pann/DifferentialActiveProbe/docs/test-runner.html

# Differential Probe - Test Runner

Save Data Load Data ✓ Saved Link Definitions File Export PDF Clear All

Serial Number

Tester Name

Test Date

Build Revision

0

Passed

0

Failed

0

Pending

Progress: 0%

### Import Test Data

Load from file:

Or paste JSON data:

Cancel Import from Text

×

### Add New Test ×

#### Basic Information

Test ID (e.g., A9, B7)

Test Name

Objective

#### Setup Steps

+ Add Setup Step

#### Procedure Steps

+ Add Procedure Step

#### Pass Criteria

Type Parameter Min Typ Max

+ Add Criterion

#### Result Fields

Generate from Criteria

Field ID Label Type Options/Step

+ Add Field

Cancel Save Test
