pann/DifferentialActiveProbe/active-diff.kicad_pcb

## KiCad design active-diff.kicad_pcb (2026-02-06)

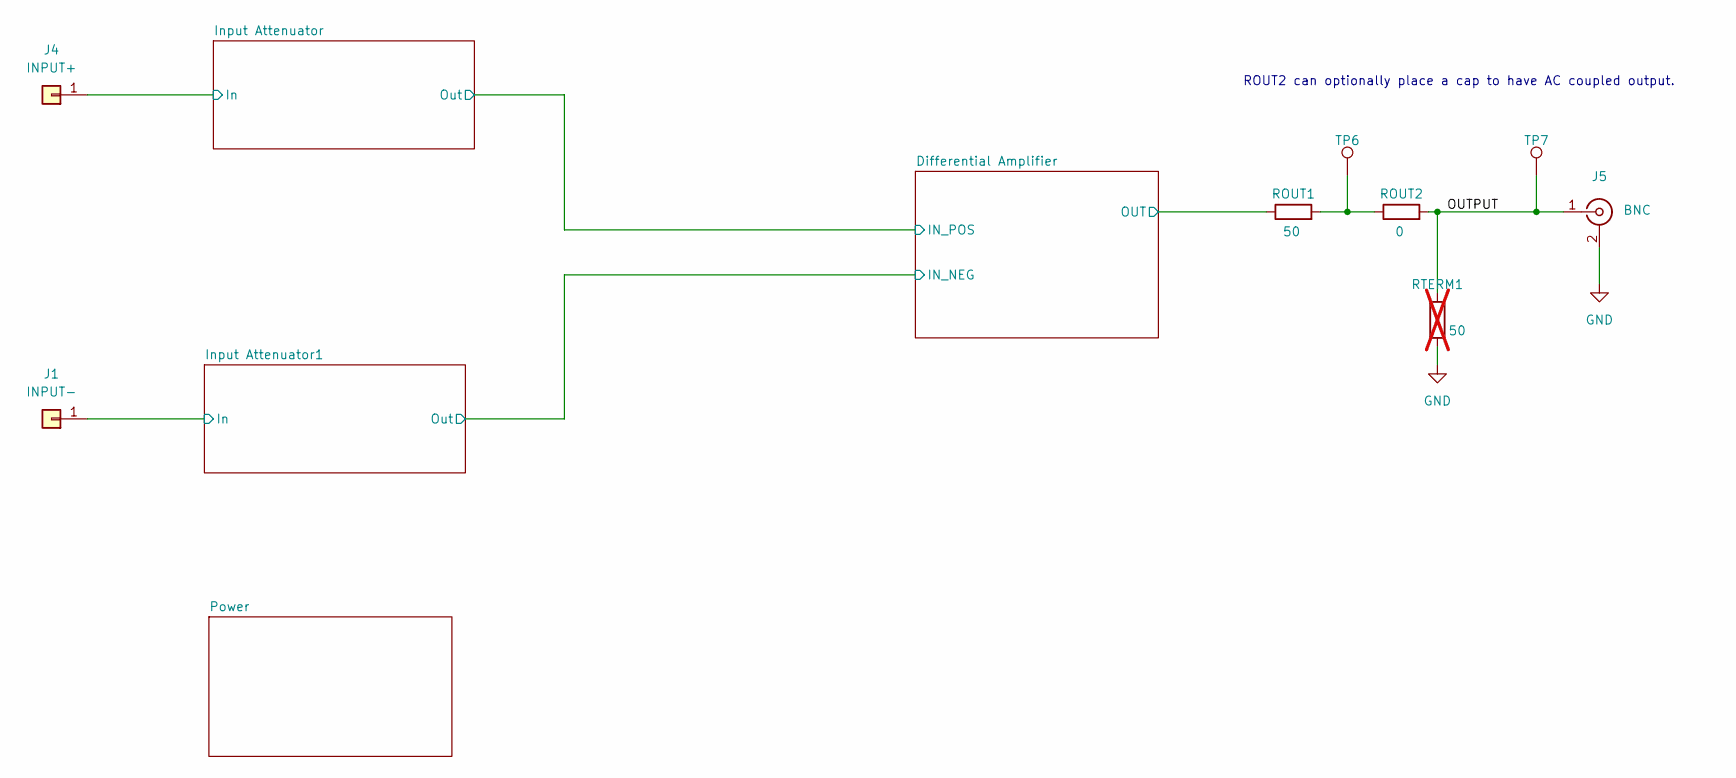
[picture p1: schematic active-diff.kicad_sch, Top]

Parts:
J1: INPUT-; TestPoint_Pad_2.5x2.5mm
J4: INPUT+; TestPoint_Pad_2.5x2.5mm
J5: BNC; BNC_Amphenol_B6252HB-NPP3G-50_Horizontal
ROUT1: 50; R_0402_1005Metric_Pad0.72x0.64mm_HandSolder; JLCPCB# C227387
ROUT2: 0; R_0402_1005Metric_Pad0.72x0.64mm_HandSolder; JLCPCB# C17168
RTERM1: 50; R_0402_1005Metric_Pad0.72x0.64mm_HandSolder; not fitted
TP6, TP7: TP; TestPoint_Pad_D1.0mm

Connections:
/Differential Amplifier/OUT: ROUT1.1; also elsewhere on the board
/Input Attenuator1/In: J1.1; also elsewhere on the board
/Input Attenuator/In: J4.1; also elsewhere on the board
/OUTPUT: J5.1 (In), ROUT2.2, RTERM1.1, TP7.1
GND: J5.2 (Ext), RTERM1.2; also elsewhere on the board
unnamed: ROUT1.2, ROUT2.1, TP6.1

Notes on the sheet:
ROUT2 can optionally place a cap to have AC coupled output.

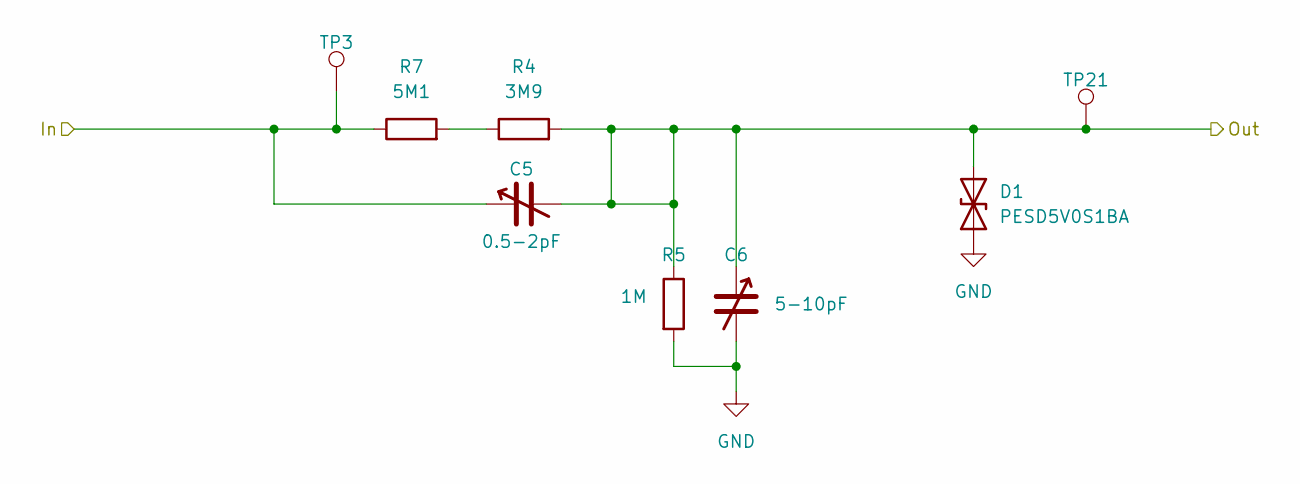
[picture p2: schematic InputAttenuator.kicad_sch]

Parts:
C5: 0.5-2pF; C_Trimmer_Murata_TZC3; JLCPCB# C22468120
C6: 5-10pF; C_Trimmer_Murata_TZC3; JLCPCB# C22468120
D1: PESD5V0S1BA; D_SOD-323_HandSoldering; JLCPCB# C2827694
R4: 3M9; R_0603_1608Metric_Pad0.98x0.95mm_HandSolder; Tolerance 0.1%; JLCPCB# C423039
R5: 1M; R_0603_1608Metric_Pad0.98x0.95mm_HandSolder; Tolerance 0.1%; JLCPCB# C4165581
R7: 5M1; R_0603_1608Metric_Pad0.98x0.95mm_HandSolder; Tolerance 0.1%; JLCPCB# C13320
TP3, TP21: TP; TestPoint_Pad_D1.0mm

Connections:
/Differential Amplifier/IN_POS: C5.2, C6.1, D1.2 (A2), R4.2, R5.1, TP21.1; also elsewhere on the board
/Input Attenuator/In: C5.1, R7.1, TP3.1; also elsewhere on the board
GND: C6.2, D1.1 (A1), R5.2; also elsewhere on the board
unnamed: R4.1, R7.2

Parts of its further copies:
C1: 0.5-2pF; C_Trimmer_Murata_TZC3; JLCPCB# C22468120
C2: 5-10pF; C_Trimmer_Murata_TZC3; JLCPCB# C22468120
D2: PESD5V0S1BA; D_SOD-323_HandSoldering; JLCPCB# C2827694
R1: 3M9; R_0603_1608Metric_Pad0.98x0.95mm_HandSolder; Tolerance 0.1%; JLCPCB# C423039
R2: 1M; R_0603_1608Metric_Pad0.98x0.95mm_HandSolder; Tolerance 0.1%; JLCPCB# C4165581
R16: 5M1; R_0603_1608Metric_Pad0.98x0.95mm_HandSolder; Tolerance 0.1%; JLCPCB# C13320
TP1, TP22: TP; TestPoint_Pad_D1.0mm

Connections of its further copies:
/Differential Amplifier/IN_NEG: C1.2, C2.1, D2.2 (A2), R1.2, R2.1, TP22.1; also elsewhere on the board
/Input Attenuator1/In: C1.1, R16.1, TP1.1; also elsewhere on the board
GND: C2.2, D2.1 (A1), R2.2; also elsewhere on the board
unnamed: R1.1, R16.2

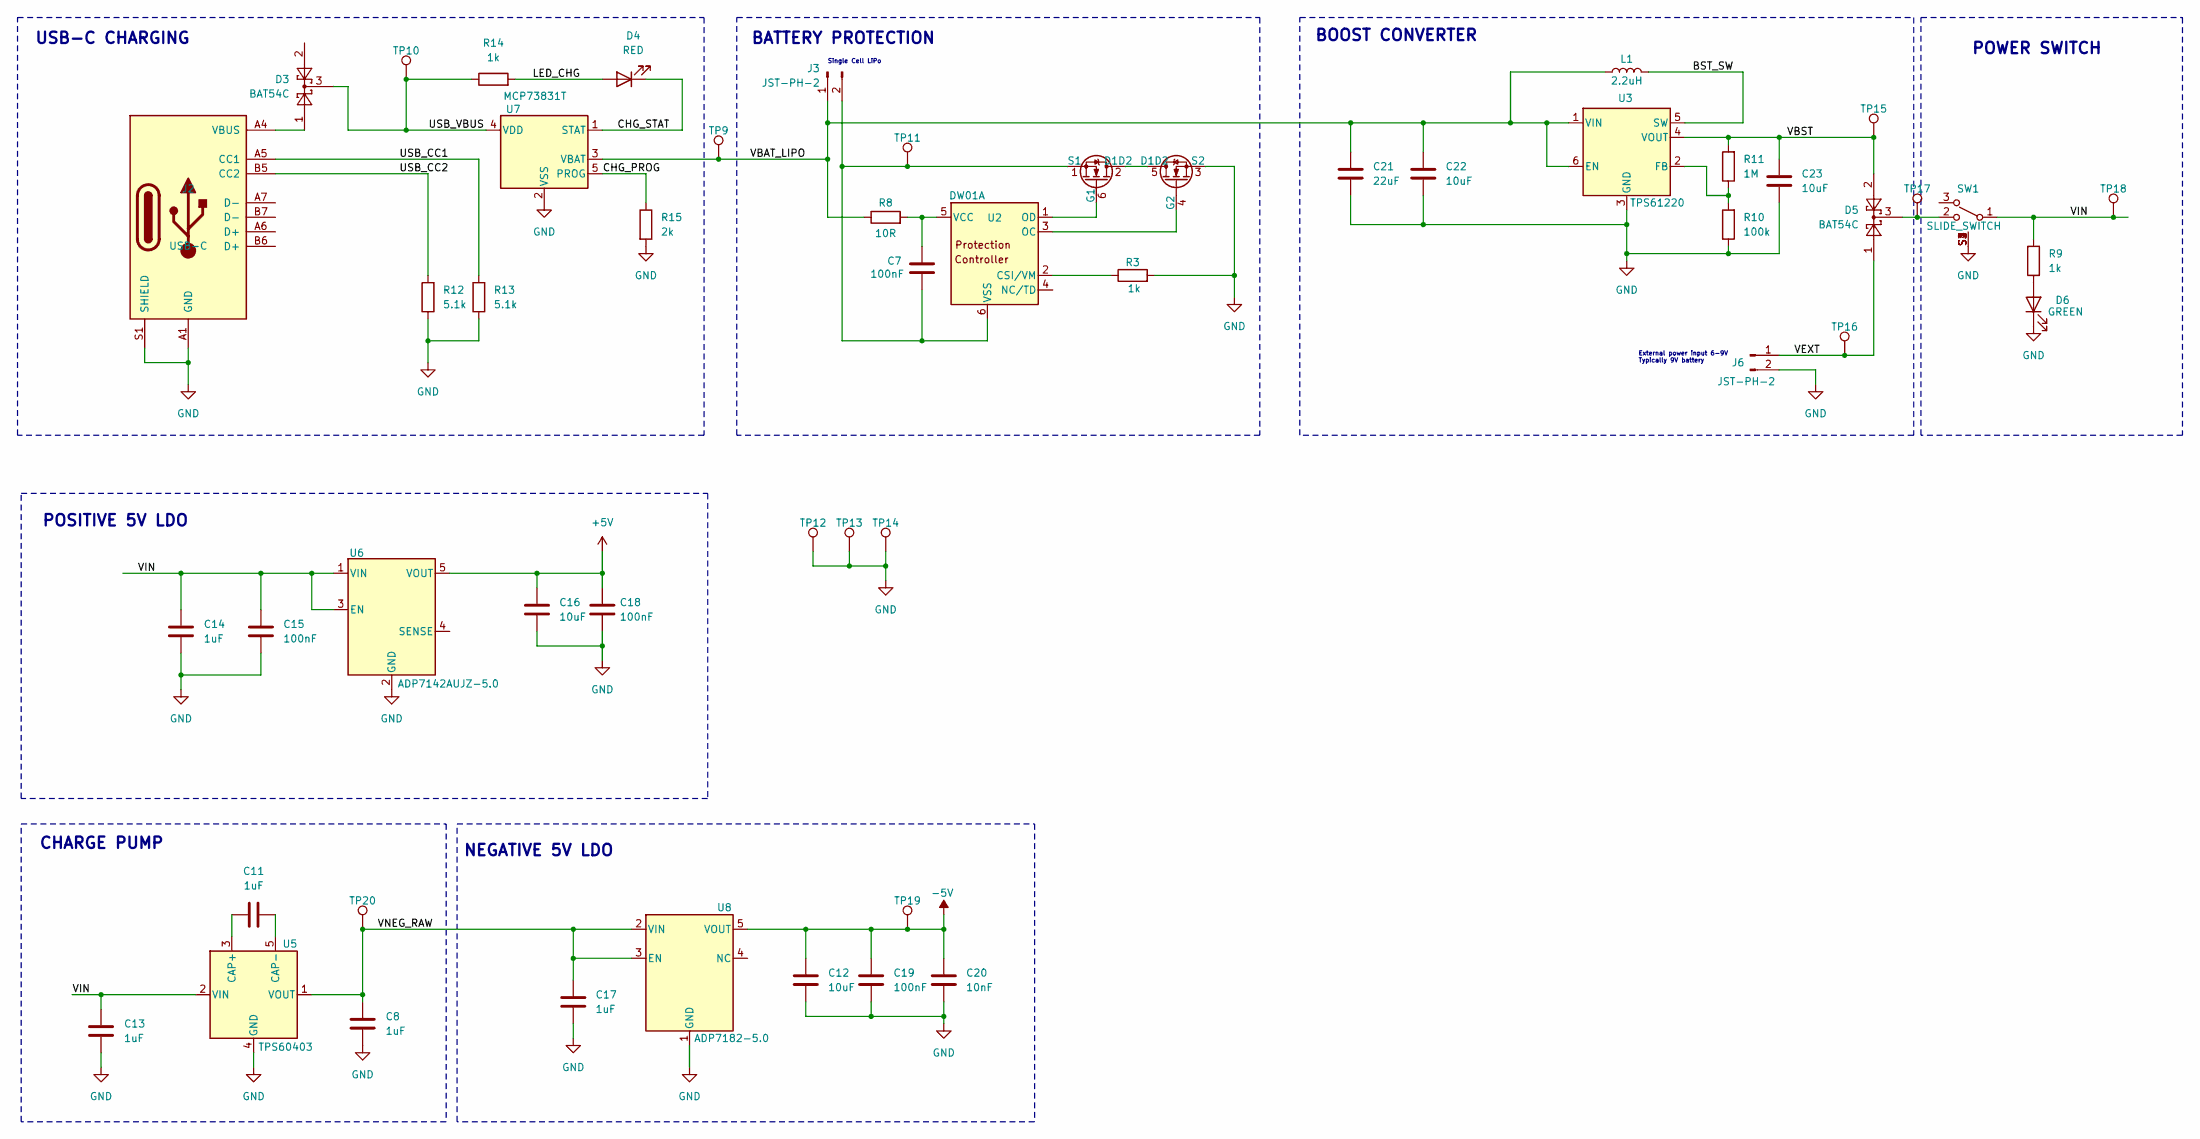
[picture p3: schematic Power.kicad_sch]

Parts:
C7: 100nF; C_0402_1005Metric_Pad0.74x0.62mm_HandSolder; Voltage 16V; JLCPCB# C60474
C8, C11, C13, C14, C17: 1uF; C_0603_1608Metric; Voltage 16V; JLCPCB# C59782
C12, C16, C22, C23: 10uF; C_0603_1608Metric_Pad1.08x0.95mm_HandSolder; Voltage 16V; JLCPCB# C237435
C15, C18, C19: 100nF; C_0402_1005Metric_Pad0.74x0.62mm_HandSolder; Voltage 10V; JLCPCB# C60474
C20: 10nF; C_0402_1005Metric_Pad0.74x0.62mm_HandSolder; Voltage 10V; JLCPCB# C15195
C21: 22uF; C_0805_2012Metric_Pad1.18x1.45mm_HandSolder; Voltage 16V; JLCPCB# C296720
D3, D5: BAT54C; SOT-23; MPN BAT54C; JLCPCB# C2135
D4: RED; LED_0805_2012Metric; JLCPCB# C2295
D6: GREEN; LED_0805_2012Metric; JLCPCB# C2297
J2: USB-C; USB_C_Receptacle_HRO_TYPE-C-31-M-12; MPN TYPE-C-31-M-12; JLCPCB# C165948
J3, J6: JST-PH-2; JST_PH_S2B-PH-K_1x02_P2.00mm_Horizontal; MPN S2B-PH-K-S; JLCPCB# C173752
L1: 2.2uH; L_Changjiang_FTC303010D; MPN VLS3012ET-2R2M; JLCPCB# C136233
Q1: FS8205A; TSOT-23-6; MPN FS8205A; JLCPCB# C2830320
R3: 1k; R_0402_1005Metric; Tolerance 1%; JLCPCB# C11702
R8: 10R; R_0402_1005Metric_Pad0.72x0.64mm_HandSolder; Tolerance 1%; JLCPCB# C25077
R9, R14: 1k; R_0402_1005Metric_Pad0.72x0.64mm_HandSolder; Tolerance 5%; JLCPCB# C11702
R10: 100k; R_0402_1005Metric_Pad0.72x0.64mm_HandSolder; Tolerance 1%; JLCPCB# C25741
R11: 1M; R_0402_1005Metric_Pad0.72x0.64mm_HandSolder; Tolerance 1%; JLCPCB# C26083
R12, R13: 5.1k; R_0402_1005Metric_Pad0.72x0.64mm_HandSolder; Tolerance 5%; JLCPCB# C25905
R15: 2k; R_0402_1005Metric_Pad0.72x0.64mm_HandSolder; Tolerance 5%; JLCPCB# C4109
SW1: SLIDE_SWITCH; SW_PCM12SMTR; MPN PCM12SMTR; JLCPCB# C221841
TP9, TP10, TP11, TP12, TP13, TP14, TP15, TP16, TP17, TP18, TP19, TP20: TP; TestPoint_Pad_D1.0mm
U2: DW01A; SOT-23-6; MPN DW01A; JLCPCB# C2927799
U3: TPS61220; SOT-363_SC-70-6; MPN TPS61220DCKR; JLCPCB# C15421
U5: TPS60403; SOT-23-5; MPN TPS60403DBVR; JLCPCB# C11338
U6: ADP7142AUJZ-5.0; TSOT-23-5; MPN ADP7142AUJZ-5.0-R7; JLCPCB# C659367
U7: MCP73831T; SOT-23-5; MPN MCP73831T-2ACI/OT; JLCPCB# C424093
U8: ADP7182-5.0; TSOT-23-5; MPN ADP7182ARDZ-5.0-R7; JLCPCB# C514357

Connections:
+5V: C16.2, C18.2, U6.5 (VOUT); also elsewhere on the board
-5V: C12.2, C19.2, C20.2, TP19.1, U8.5 (VOUT); also elsewhere on the board
/Power/BST_SW: L1.2, U3.5 (SW)
/Power/CHG_PROG: R15.1, U7.5 (PROG)
/Power/CHG_STAT: D4.1 (K), U7.1 (STAT)
/Power/LED_CHG: D4.2 (A), R14.2
/Power/USB_CC1: J2.A5 (CC1), R13.2
/Power/USB_CC2: J2.B5 (CC2), R12.2
/Power/USB_VBUS: D3.3, R14.1, TP10.1, U7.4 (VDD)
/Power/VBAT_LIPO: C21.2, C22.2, J3.1, L1.1, R8.1, TP9.1, U3.1 (VIN), U3.6 (EN), U7.3 (VBAT)
/Power/VBST: C23.2, D5.2, R11.2, TP15.1, U3.4 (VOUT)
/Power/VEXT: D5.1, J6.1, TP16.1
/Power/VIN: C13.2, C14.2, C15.2, R9.2, SW1.1 (A), TP18.1, U5.2 (VIN), U6.1 (VIN), U6.3 (EN)
/Power/VNEG_RAW: C8.2, C17.2, TP20.1, U5.1 (VOUT), U8.2 (VIN), U8.3 (EN)
GND: C8.1, C12.1, C13.1, C14.1, C15.1, C16.1, C17.1, C18.1, C19.1, C20.1, C21.1, C22.1, C23.1, D6.1 (K), J2.A1 (GND), J2.A12 (GND), J2.B1 (GND), J2.B12 (GND), J2.S1 (SHIELD), J6.2, Q1.3 (S2), R3.2, R10.1, R12.1, R13.1, R15.2, SW1.S1, SW1.S2, SW1.S3, SW1.S4, TP12.1, TP13.1, TP14.1, U3.3 (GND), U5.4 (GND), U6.2 (GND), U7.2 (VSS), U8.1 (GND); also elsewhere on the board
unnamed: D3.1, J2.A4 (VBUS), J2.A9 (VBUS), J2.B4 (VBUS), J2.B9 (VBUS)
unnamed: D5.3, SW1.2 (B), TP17.1
unnamed: D6.2 (A), R9.1
unnamed: C7.2, J3.2, Q1.1 (S1), TP11.1, U2.6 (VSS)
unnamed: Q1.2 (D1D2), Q1.5 (D1D2)
unnamed: Q1.6 (G1), U2.1 (OD)
unnamed: Q1.4 (G2), U2.3 (OC)
unnamed: R3.1, U2.2 (CSI/VM)
unnamed: C7.1, R8.2, U2.5 (VCC)
unnamed: R10.2, R11.1, U3.2 (FB)
unnamed: C11.2, U5.3 (CAP+)
unnamed: C11.1, U5.5 (CAP-)

Parts of its further copies:
TP1: TP; TestPoint_Pad_D1.0mm

Connections of its further copies:
/Input Attenuator1/In: TP1.1; also elsewhere on the board

Notes on the sheet:
USB-C CHARGING
POSITIVE 5V LDO
CHARGE PUMP
POWER SWITCH
BATTERY PROTECTION
BOOST CONVERTER
NEGATIVE 5V LDO
Single Cell LiPo
External power input 6-9V Typically 9V battery

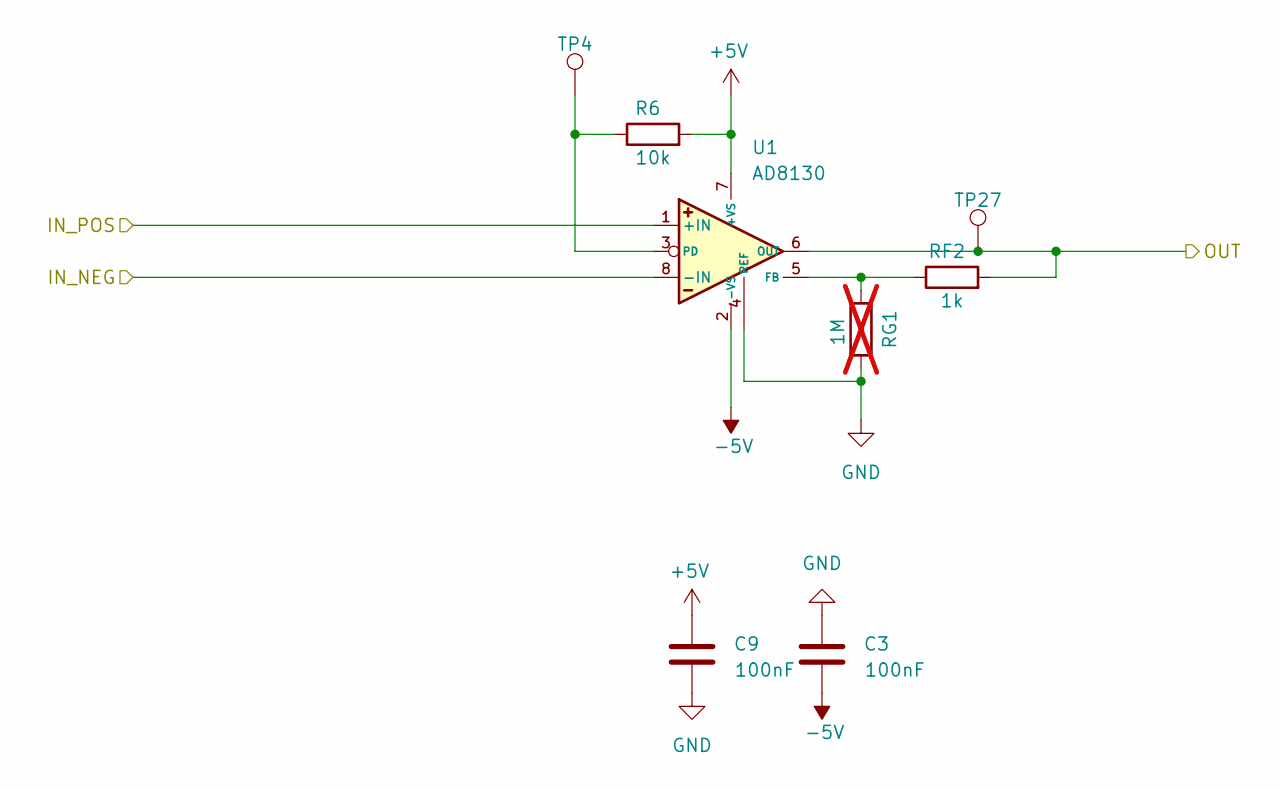
[picture p4: schematic DiffAmp.kicad_sch, Differential Amplifier]

Parts:
C3, C9: 100nF; C_0402_1005Metric_Pad0.74x0.62mm_HandSolder; Voltage 16V; JLCPCB# C60474
R6: 10k; R_0402_1005Metric_Pad0.72x0.64mm_HandSolder; Tolerance 0.1%; JLCPCB# C25744
RF2: 1k; R_0402_1005Metric_Pad0.72x0.64mm_HandSolder; Tolerance 0.1%; JLCPCB# C11702
RG1: 1M; R_0402_1005Metric_Pad0.72x0.64mm_HandSolder; Tolerance 0.1%; not fitted
TP4, TP27: TP; TestPoint_Pad_D1.0mm
U1: AD8130; SOIC-8_3.9x4.9mm_P1.27mm; JLCPCB# C41661

Connections:
+5V: C9.1, R6.2, U1.7 (+VS); also elsewhere on the board
-5V: C3.2, U1.2 (-VS); also elsewhere on the board
/Differential Amplifier/IN_NEG: U1.8 (-IN); also elsewhere on the board
/Differential Amplifier/IN_POS: U1.1 (+IN); also elsewhere on the board
/Differential Amplifier/OUT: RF2.2, TP27.1, U1.6 (OUT); also elsewhere on the board
GND: C3.1, C9.2, RG1.2, U1.4 (REF); also elsewhere on the board
unnamed: RF2.1, RG1.1, U1.5 (FB)
unnamed: R6.1, TP4.1, U1.3 (PD)

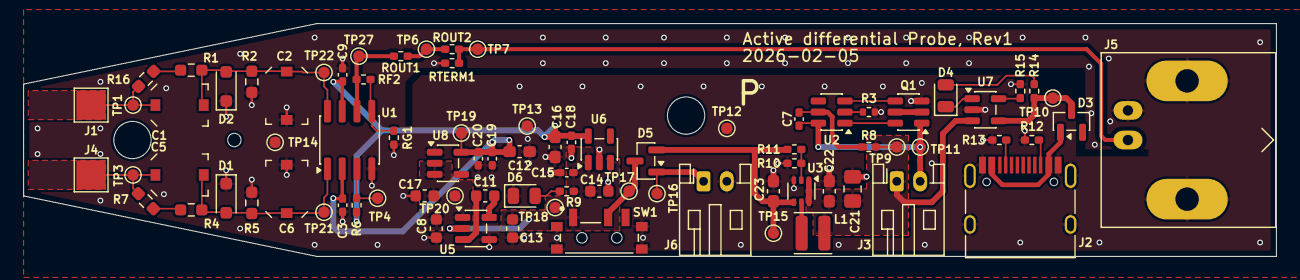
[picture p5: board active-diff.kicad_pcb from above]

Board: 2 copper layers, 107.6 x 20.0 mm, 84 parts (0 on the bottom side), 38 nets.
