pann/DifferentialActiveProbe/(commit log)

2026-01-21 Add CLAUDE.md with project documentation for Claude Code
    Documents JSON-to-KiCad workflow, schematic hierarchy, supported
    libraries, and circuit design notes for the differential probe project.
    [Power.kicad_sch]
2026-01-21 Add PCM12SMTR SPDT slide switch footprint
    C&K ultraminiature SMD slide switch with 3 signal pads (1.5mm pitch)
    and 2 mounting pads. Includes 3D model reference.
2026-02-04 DRC completed. Need to add some 3D models.
    [DiffAmp.kicad_sch, InputAttenuator.kicad_sch, Power.kicad_sch, active-diff.kicad_pcb, active-diff.kicad_sch, buffer.kicad_sch]
2026-02-06 R1 sent to JLCPCB
    [BOM-claude.csv, DiffAmp.kicad_sch, InputAttenuator.kicad_sch, Power.kicad_sch, active-diff-BOM.csv, active-diff.kicad_pcb, active-diff.kicad_sch]
2026-02-06 Update documentation and schematics for AD8130 design
    Documentation updates:
    - CLAUDE.md: Fixed schematic hierarchy (removed buffer.kicad_sch,
    updated DiffAmp description to AD8130, corrected bandwidth to 270MHz)
    - Power supply design doc: Updated load requirements for AD8130
    (single IC vs 3 ICs), corrected circuit block references
    Schematic updates:
    - Renamed JLCPCB# property to JLCPCB Part# in all schematic files
    (InputAttenuator, DiffAmp, Power, active-diff)
    - Removed unused buffer.kicad_sch (orphaned from earlier design)
    New files:
    - docs/index.html: Documentation index with categories
    (Design Input, Component Selection, Datasheets, Calibration,
    Manufacturing, KiCad Project)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
    [DiffAmp.kicad_sch, InputAttenuator.kicad_sch, Power.kicad_sch, active-diff.kicad_sch, buffer.kicad_sch]
2026-02-06 Add comprehensive test plan for probe validation
    Test_Plan.md includes 29 tests across 6 categories:
    - A. Power Supply (8 tests): power-on, noise, current, charging,
    switchover, low battery, voltage range
    - B. DC Performance (6 tests): attenuation, offset, impedance,
    max input, common mode, channel balance
    - C. AC Performance (7 tests): frequency response, step response,
    compensation, phase, slew rate, output drive, distortion
    - D. CMRR (4 tests): DC, 1kHz, 1MHz, 10MHz
    - E. Input Protection (3 tests): TVS clamping, ESD, reverse polarity
    - F. Environmental (2 tests): temperature, long-term stability
    Each test includes setup, procedure, pass criteria, and results fields.
    Test summary sh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
2026-02-06 Add delete button for test run history entries
    - Each history item now has a delete (×) button
    - Confirmation prompt before deletion
    - Automatically updates summary stats after delete
    - Removes test from results if all runs deleted
2026-02-06 Add image upload support for test runs
    - Add file input to attach images to test results
    - Store images as base64 in test data
    - Show thumbnails in test history view
    - Click thumbnail to open full-size lightbox modal
    - Preview and clear image before recording result
2026-02-06 Add PDF test report export
    - Add jsPDF library for PDF generation
    - Export PDF Report button in header
    - Report includes:
    - Title with project name and date
    - DUT info (revision, serial, tester)
    - Summary section (pass/fail/pending counts, progress)
    - Results for last run of each test by category
    - Measurement values and notes
    - Filename: DifferentialProbe-TestReport-YYYY-MM-DD.pdf
    - Automatic page breaks for long reports
2026-02-08 Replace tuning PNG images with comprehensive SVG versions
    All four tuning guide images recreated as SVG with complete information:
    tuning_step_response_method.svg:
    - Step response showing under/optimal/over compensation
    - 10 MHz square wave comparison
    - Settling time vs C1 curve (was missing data in PNG)
    - Scope probe loading frequency response
    - Key takeaways summary
    tuning_frequency_method.svg:
    - Frequency ratio method graph
    - Amplitude at test frequencies for different C1 values
    - Measurement uncertainty analysis
    - Complete recommended tuning procedure
    - Verification steps
    tuning_practical_guide.svg:
    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
2026-02-08 Add C2 trimmer role explanation to tuning guides
    Updated tuning SVGs to explain C2's function:
    - C2 sets the bandwidth pole location
    - Compensation relationship: C2 = 9 × C1 (for R1=9MΩ, R2=1MΩ)
    - C2 adjustment affects bandwidth vs tuning ease trade-off
    - C2/C4 used for CMRR optimization (channel matching)
    Added Step 3 (C2 bandwidth optimization) and Step 4 (CMRR)
    to practical guide with clear guidance on when to adjust C2.
2026-02-08 Clarify DC vs AC channel matching for CMRR
    Updated Step 4 to distinguish between:
    - DC CMRR test: Apply DC common-mode, check for offset
    (depends on resistor matching - not adjustable with trimmers)
    - AC CMRR test: Apply 1MHz AC common-mode, adjust C2/C4
    (capacitor matching - adjustable)
    This addresses that capacitors don't affect DC response,
    so DC channel balance depends entirely on matched resistors.
2026-02-08 Update test plan and runner for DC vs AC CMRR distinction
    Test Plan updates:
    - D1: Clarify DC CMRR depends on resistor matching only (not adjustable)
    - D2: Note low-freq AC is also resistor-dominated
    - D3: Add C2/C4 optimization procedure for high-freq AC CMRR
    - C3: Complete two-step procedure:
    1. Differential response tuning (C1/C3)
    2. AC CMRR optimization (C2/C4)
    Test Runner updates:
    - D1: Add +2V test point, note about non-adjustability
    - D3: Add before/after trim fields, C2/C4 adjustment tracking
    - C3: Renamed C5/C6 to C3/C4, added CM output field and verification
    Key insight: Capacitors are open circuits at DC, so DC channel
    matching depends entirely on resistor pair matching (0.1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
2026-02-08 Move test data to separate JSON file
    - Create test-data.json for storing test results
    - Add File System Access API support for direct file save/load
    - Add save indicator showing unsaved changes
    - Load data from file on startup (falls back to localStorage)
    - "Save Data" button writes to file (or downloads if API unavailable)
    - "Load Data" button opens file picker
    - Import modal now has file upload option
    - Warn before leaving page with unsaved changes
2026-02-08 Add test management with auto-save to definitions file
    - Add delete button for each test in the test runner
    - Add "Add Test" button for each category with full form
    (name, objective, setup, procedure, criteria, result fields)
    - Auto-save to test-definitions.json when adding/deleting tests
    - Use File System Access API for direct file writes
    - Visual indicator when there are unsaved definition changes
